openmeddev/Diabeto_Hardware_OpenSource/Diabeto_HW_OpenSource/Documents/Bill Of Material/Diabeto_BLE_BOM.xls

Reference | Value | Quantity | Package | Description | Manufacture | Mfg PN
BAT+,BAT- | 3.7V/55mAh | 1 | 1X01_ROUND | 3.7v/55mAh LIPO rechargable battery, dimension 21.5x10x4mm | Full aim technology Ltd | 8EB-401120
C1,C4,C6,C7,C14, C15,C33 | 0.1uF | 7 | _0603 | CAP CER 0.1UF 10V 10% X7R 0603 | kemet | C0603C104K8RACTU
C2,C3,C12,C13 | 22pF | 4 | _0402 | CAP CER 22PF 50V 5% NP0 0402 | Samsung Electro-Mechanics America, Inc | CL05C220JB5NNNC
C5 | 10uF | 1 | 1206 | CAP CER 10UF 10V 5% X7R 1206 | kemet | C1206C106J8RACTU
C8 | 22uF | 1 | SMD 0805 | CAP CER 22UF 10V 20% X5R 0805 | Samsung Electro-Mechanics America, Inc | CL21A226MPQNNNE
C9 | 47nF | 1 | _0603 | CAP CER 0.047UF 50V 10% X7R 0603 | Samsung Electro-Mechanics America, Inc | CL10B473KB8NNNC
C10 | 2.2uF | 1 | _0603 | CAP CER 2.2UF 6.3V Y5V 0603 | Yageo | CC0603ZRY5V5BB225
C11,C21 | 4.7uF | 2 | _0603 | CAP CER 4.7UF 25V 20% X5R 0603 | Samsung Electro-Mechanics America, Inc | CL10A475MA8NQNC
D1 | BAV70 | 1 | SOT-23 | DIODE ARRAY 75V 150MA SOT23 | Diodes Inc (http://digikey.com/Suppliers/us/Diodes.page?lang=en) | BAV70-7-F
D2 | 1N5817 | 1 | SMA-DIODE/SOD-123 | DIODE SCHOTTKY 40V 1A SOD123 | Diodes Inc | 1N5819HW-7-F
IC1 | ATMEGA8L | 1 | TQFP32-08 | MCU 8bit, 8KB flash,1KB SRAM,512 Bytes EEPROM | Atmel | ATMEGA8L-8AUR
LED1 | WHITE | 1 | CHIPLED_0603 | LED WHITE HIGH BRIGHT ESS SMD, 2.9V, 5mA | Rohm Semiconductor | SMLT12WBC7W1
LED2 | BLUE | 1 | CHIPLED_0603 | LED BLUE HIGH BRIGHT ESS SMD,2.9v, 5mA | Panasonic Electronic Components - Semiconductor Products | LNJ937W8CRA
LED3 | RED | 1 | CHIPLED_0603 | LED RED HIGH BRIGHT ESS SMD, 1.95v, 5mA | Panasonic Electronic Components - Semiconductor Products | LNJ237W82RA
LED4 | GREEN | 1 | CHIPLED_0603 | LED GREEN USS TYPE 0603, 2.03v, 10mA | Panasonic Electronic Components - Semiconductor Products | LNJ314G83RA
NR3015 | 2.2uH, 1.6A | 1 | 1210 | INDUCTOR POWER 2.2UH 1600MA 1210 | Murata Electronics North America (http://digikey.com/Suppliers/us/Murata-Electronics.page?lang=en) | LQH32PN2R2NN0L
R2,R3,R4,R5 | 100E | 4 | _0603 | RES 100 OHM 1/10W 5% 0603 | Stackpole Electronics Inc | RMCF0603JT100R
R1,R6,R7,R15,R17,R22 | 10K | 6 | _0603 | RES 10K OHM 1/10W 5% 0603 | Stackpole Electronics Inc | RMCF0603JG10K0
R8 | 15k | 1 | _0603 | RES 15K OHM 1/10W 5% 0603 | Stackpole Electronics Inc | RMCF0603JG15K0
R9, R20 | 1k | 2 | _0603 | RES 1K OHM 1/10W 5% 0603 | Stackpole Electronics Inc | RMCF0603JT1K00
R14,R12 | 2M | 2 | _0603 | RES 2M OHM 1/10W 5% 0603 | Stackpole Electronics Inc | RMCF0603JG2M00
R16,R19 | 220k | 2 | _0603 | RES 220K OHM 1/10W 5% 0603 | Stackpole Electronics Inc | RMCF0603JT220K
R11,R18 | 1.2M | 2 | _0603 | RES 1.2M OHM 1/10W 5% 0603 | Samsung Electro-Mechanics America, Inc | RC1608J125CS
R23 | 1.5k | 1 | _0603 | RES 1.5K OHM 1/10W 5% 0603 | Stackpole Electronics Inc | RMCF0603JT1K50
R24,R25 | 68E | 2 | _0603 | RES 68 OHM 1/10W 1% 0603 | Stackpole Electronics Inc | RMCF0603FT68R0
R26 | 47K | 1 | _0603 | RES 47K OHM 1/10W 5% 0603 | Stackpole Electronics Inc | RMCF0603JT47K0
S1 | SOFT_BUTTON | 1 | TACTILE_SWITCH_SMD | Tactile Switches 5.2x5.2x1.5mm 260gf | ALPS | SKQGADE010
U$9 | NVC_MDCS71 | 1 | NVC_MDCS71 SMD SOIC | Novacomm Bluetooth4.0 compatible low energy module | Novacomm | NVC_MDCS71
U$17 | ATTINY2313V | 1 | MLF20 | MCU 8bit,2KB flash,128 Bytes SRAM | Atmel | ATTINY2313V-10MU
U1 | MCP73831 | 1 | SOT23-5 | Singel Cell LIPO charger with programmable o/p current upto 500mA | Microchip | MCP73831T-2ACI/OT
U2 | TPS61200 | 1 | QFN-10_PAD | IC REG BOOST SYNC ADJ 1.2A 10SON | Texas | TPS61200DRCR
X1 | USB-MICRO-B | 1 | SMD MID-MOUNT | standard micro usb B type connector | chinaplug | GW-MC510B-01S
Y1 | 8MHz | 1 | CRYSTAL-SMD-5X3 | 5x3.2x1.5mm SMD crystal, +/-50ppm tolerance,300ohm ESR,8pF | NDK | NX5032GA 8MHZ AT-W
Y2 | 12MHz | 1 | CRYSTAL_3.2X2.5 | 3.2x2.5mm SMD crystal | Abracon | ABM8G-12.000MHZ-B4Y-T
 | 2.5mm Audio jack | 1 | PTH | standard 2.5 mm audio connector | chinaplug | 2.5 STEREO PLUG
 | TS3A5223 | 1 | 10-UFQFN | DUAL SPDT ANALOG SWITCH | Texas | TS3A5223RSWR
 | PCB manufacturing | 1
 | Micro-usb cable | 1 |  | USB2.0 to micro usb converter cable | chinaplug
 | Outer casing
R10 | 2K | 1 | _0603 | Resistor 2k | Stackpole Electronics Inc
R21 | 33E | 1 | _0603 | Resistor | Stackpole Electronics
D3 | 1N4001 | 1 | SOD323 | Diode
Q1 | 2N3904 | 1 | SOT23 |  | Fairchild Semiconductor
VIB+, VIB- | 310-101 | 1 | 10mm shaftless vibration motor | 2.5-3.8,70mA,3.4mm button type | Pricision Microdrivers | 310-101
