openmeddev/Diabeto_Hardware_OpenSource/Diabeto_HW_OpenSource/Design Files/Eagle Files/DIABETO_BLE_SCH_SHEET1.pdf

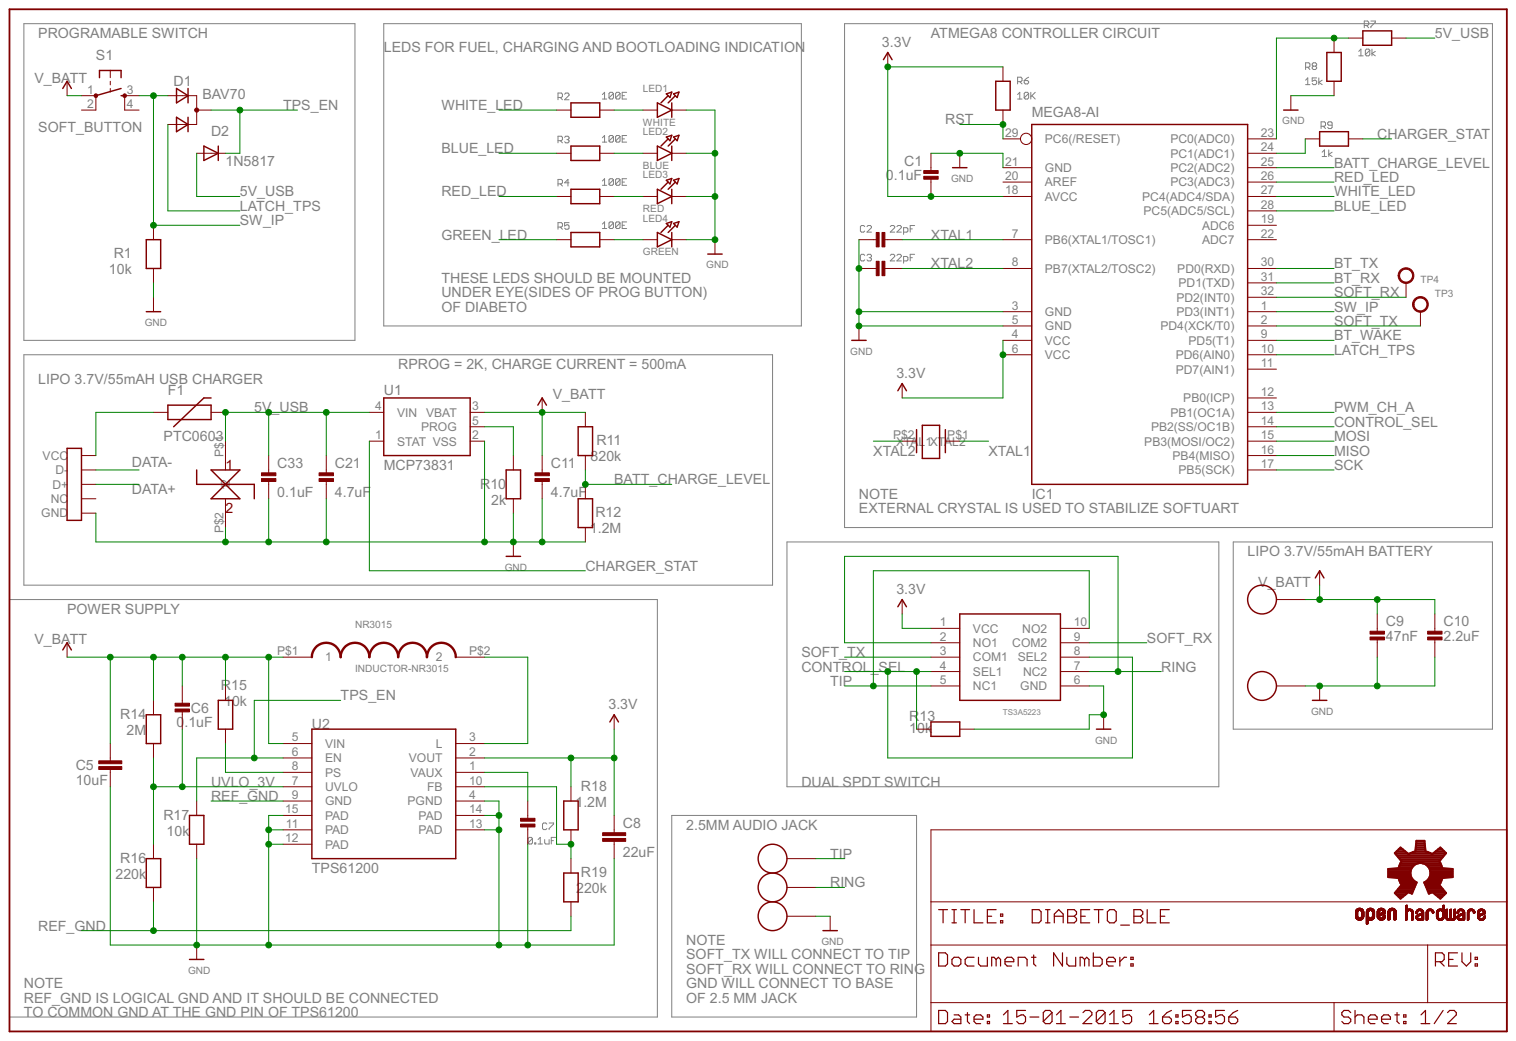
[picture p1: page 1]

LEDS FOR FUEL, CHARGING AND BOOTLOADING INDICATION

THESE LEDS SHOULD BE MOUNTED
UNDER EYE(SIDES OF PROG BUTTON)
OF DIABETO

NOTE
EXTERNAL CRYSTAL IS USED TO STABILIZE SOFTUART

SOFT_TX WILL CONNECT TO TIP
SOFT_RX WILL CONNECT TO RING
GND WILL CONNECT TO BASE
OF 2.5 MM JACK

REF_GND IS LOGICAL GND AND IT SHOULD BE CONNECTED
TO COMMON GND AT THE GND PIN OF TPS61200
