openmeddev/Diabeto_Hardware_OpenSource/Diabeto_HW_OpenSource/Design Files/Eagle Files/DIABETO_BLE_SCH_SHEET2.pdf

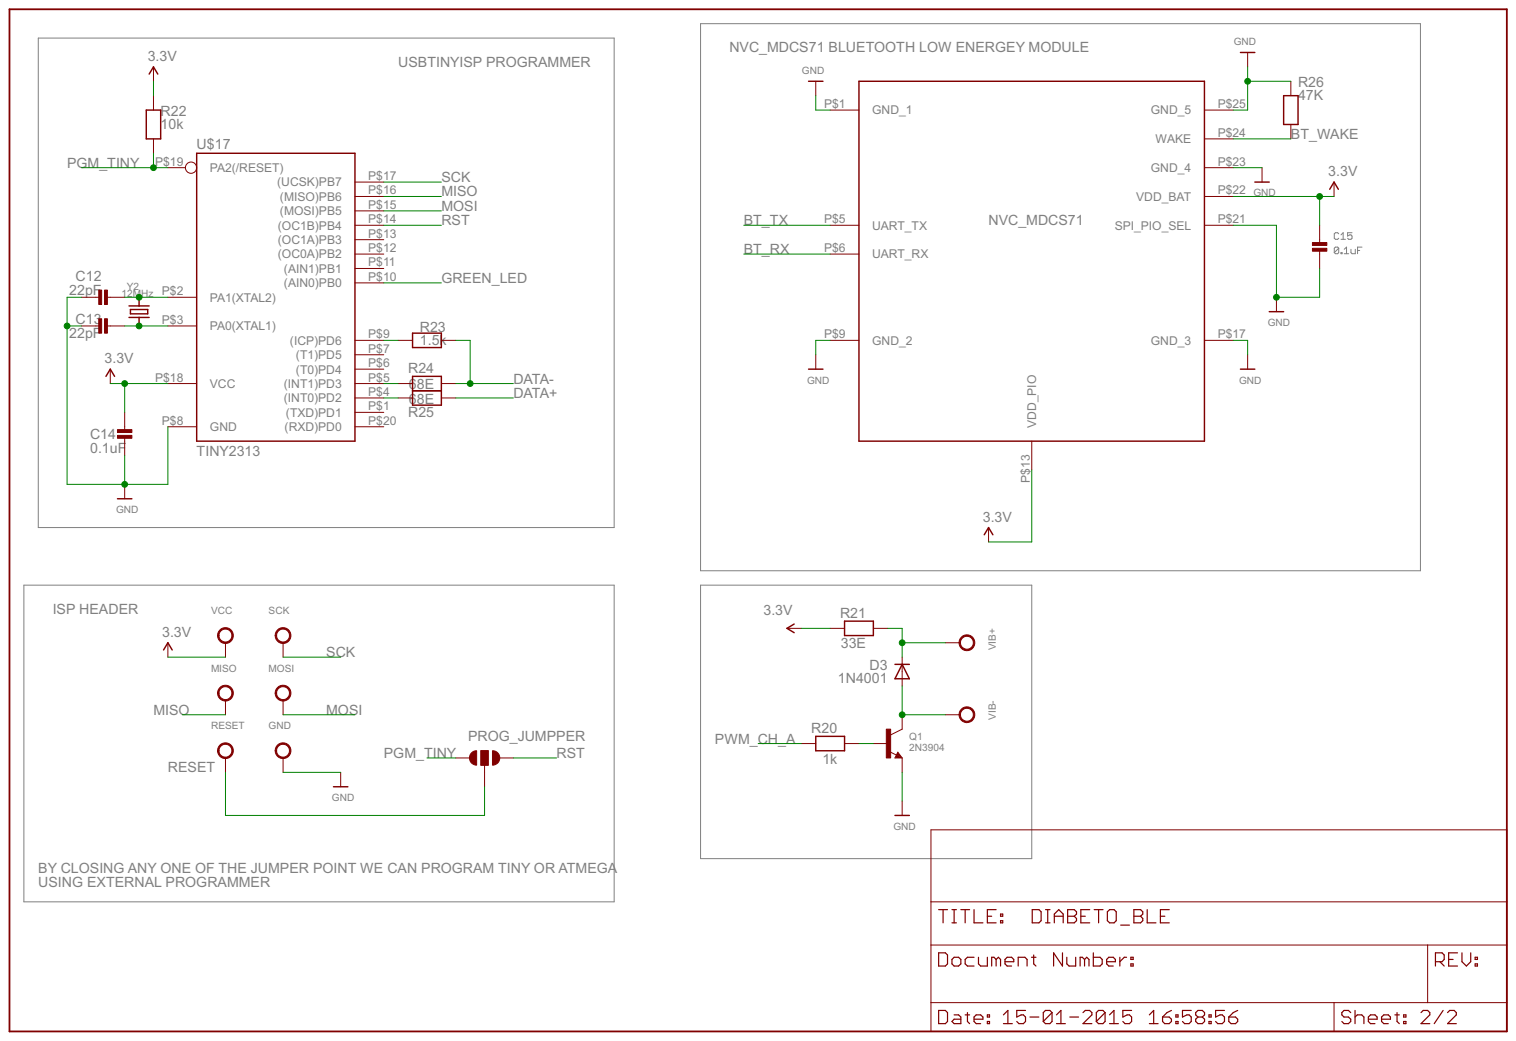
[picture p2: page 1]

NVC_MDCS71 BLUETOOTH LOW ENERGEY MODULE

BY CLOSING ANY ONE OF THE JUMPER POINT WE CAN PROGRAM TINY OR ATMEGA
USING EXTERNAL PROGRAMMER
