openmeddev/Diabeto_Hardware_OpenSource/Diabeto_HW_OpenSource/Documents/Databook/Micro usb 5P_SMT.pdf

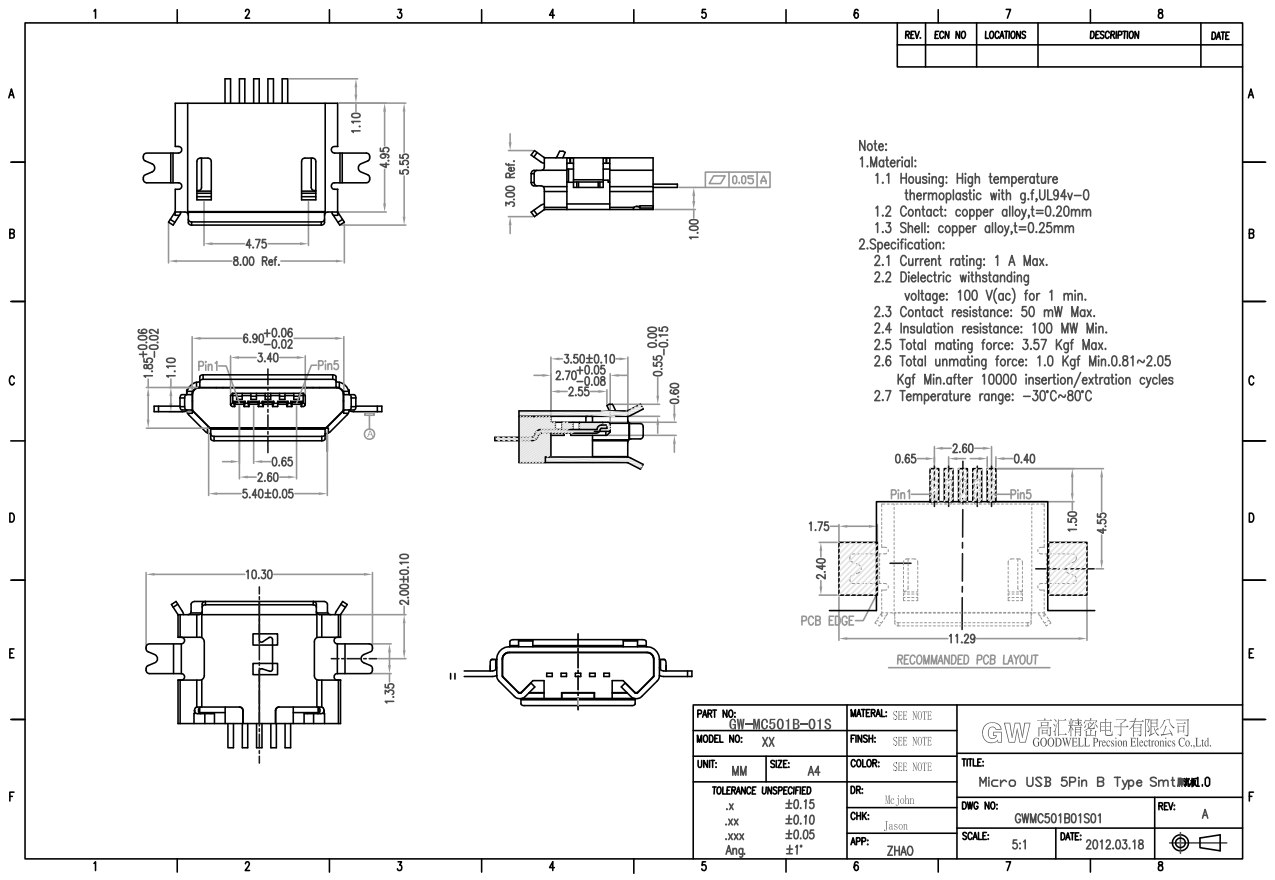
[picture p3: page 1]
