openmeddev/Diabeto_Hardware_OpenSource/Diabeto_HW_OpenSource/Design Files/Eagle Files/DIABETO_BLE.brd

## EAGLE design Diabeto_HW_OpenSource/Design Files/Eagle Files/DIABETO_BLE.brd (2015-01-17)

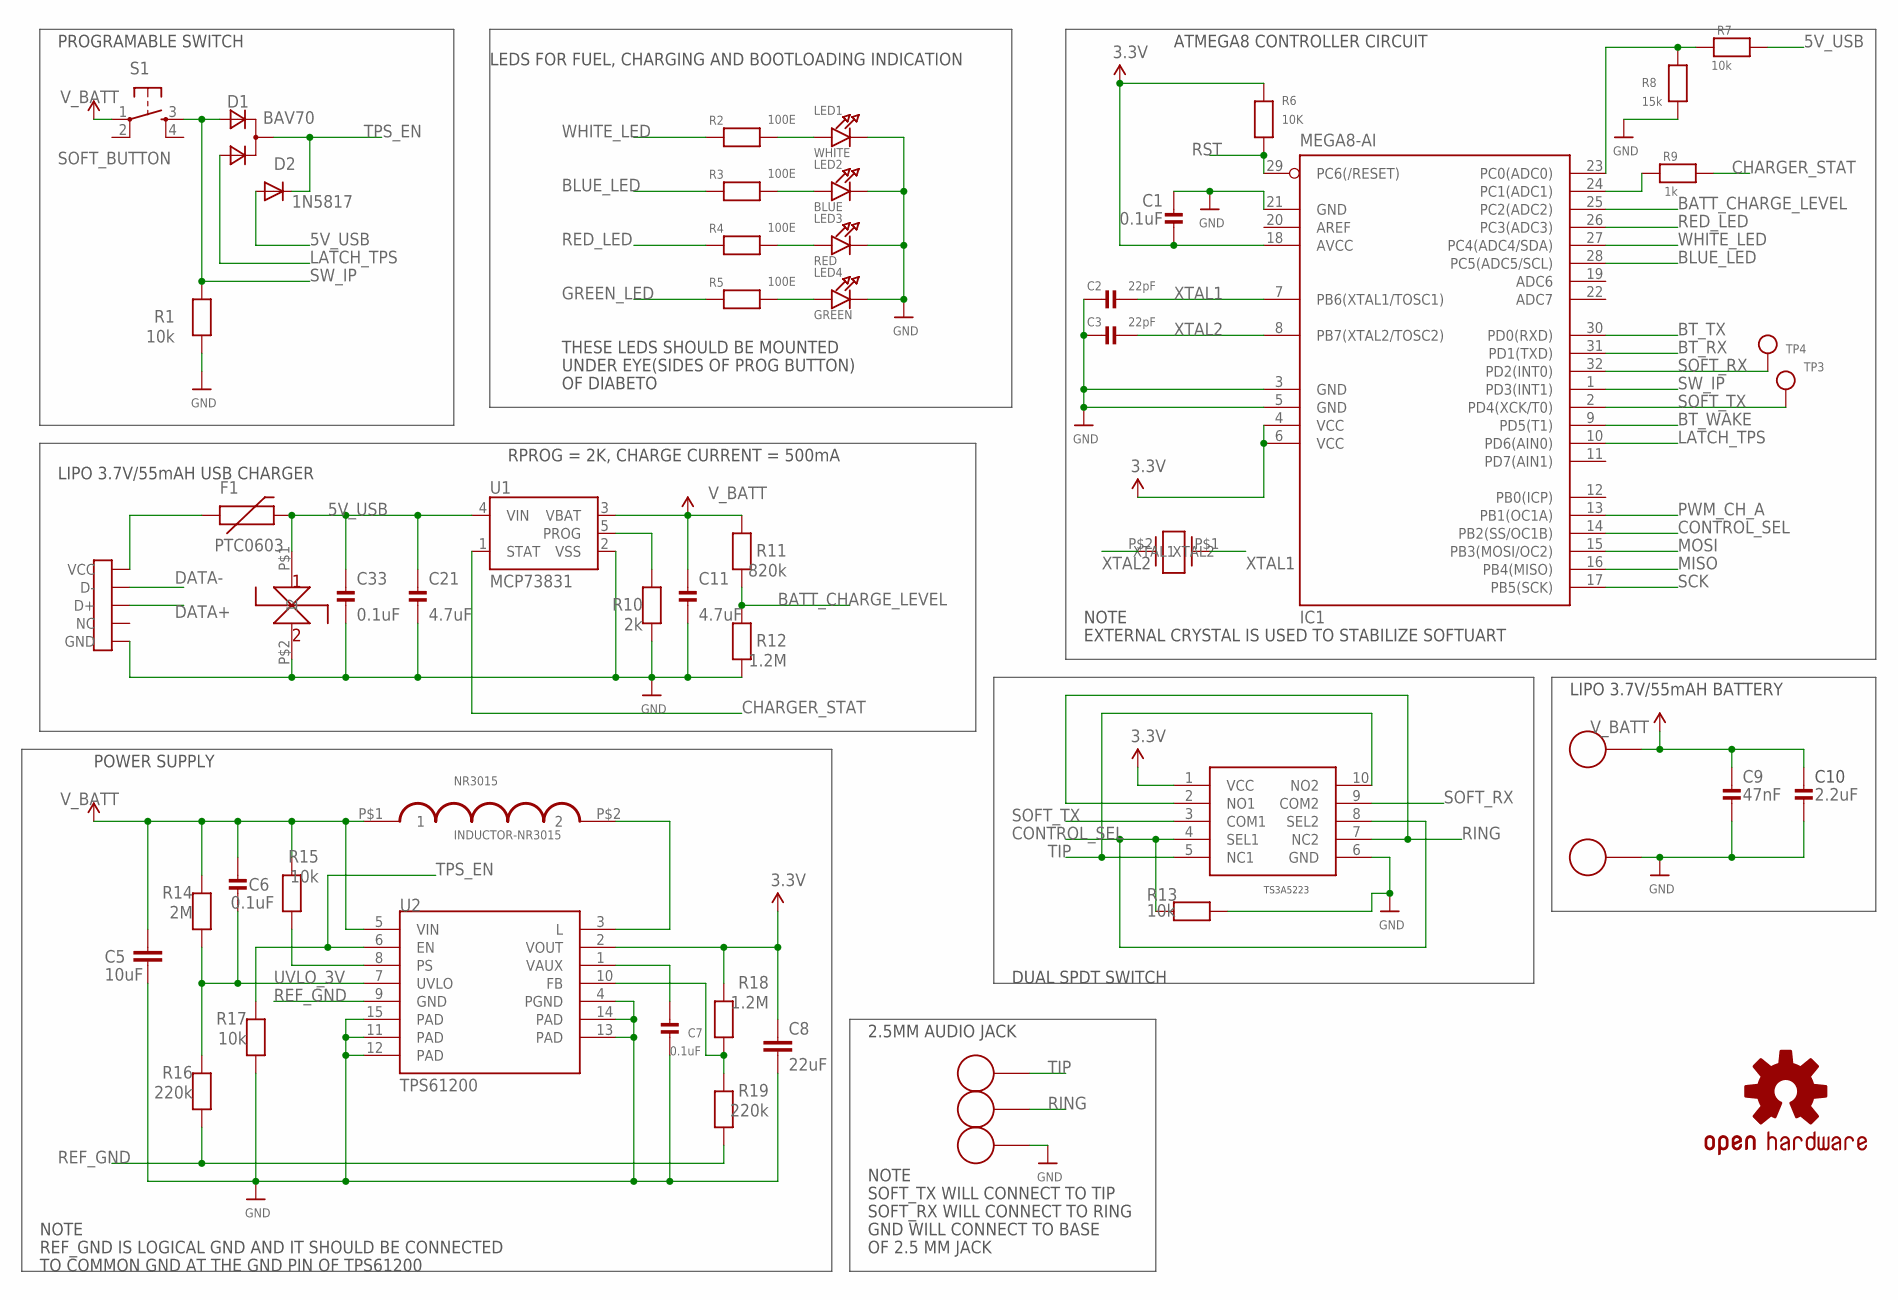
[picture p4: schematic DIABETO_BLE.sch, sheet 1]

Parts:
BAT-: TIP; 1X01_ROUND
C1, C6, C7, C33: 0.1uF; _0603
C2, C3: 22pF; _0402
C5: 10uF; 1206
C8: 22uF; 0805
C9: 47nF; _0603
C10: 2.2uF; _0603
C11, C21: 4.7uF; _0603
D1: BAV70; SOT-23
D2: 1N5817; SOD-123
F1: PTC0603; 0603
IC1: MEGA8-AI; TQFP32-08
LED1: WHITE; CHIPLED_0603
LED2: BLUE; CHIPLED_0603
LED3: RED; CHIPLED_0603
LED4: GREEN; CHIPLED_0603
NR3015: INDUCTOR-NR3015
R1, R7, R13, R15, R17: 10k; _0603
R2, R3, R4, R5: 100E; _0603
R6: 10K; _0603
R8: 15k; _0603
R9: 1k; _0603
R10: 2k; _0603
R11: 820k; _0603
R12, R18: 1.2M; _0603
R14: 2M; _0603
R16, R19: 220k; _0603
S1: SOFT_BUTTON; TACTILE_SWITCH_SMD
TIP, TIP1: TIP; 1X01_ROUND
TP3, TP4: TESTPOINTROUND1MM; TESTPOINT_ROUND_1MM
U1: MCP73831; SOT23-5
U2: TPS61200; QFN-10_PAD
U$2: MICRO_USB_DIABETOMICRO_USB_SMD; MICRO_USB_DIABETO
U$4: TVS_DIODE; 0603
U$20: TS3A5223; TS3A5223-QFN
U$21: OSHW-LOGOS; OSHW-LOGO-S
U$23: 8MHZ; 5X3.2_2PAD
U$26, U$28: 1X01_ROUND

Connections:
3.3V: C1.1, C8.1, IC1.4 (VCC), IC1.6 (VCC), IC1.18 (AVCC), R6.2, R18.2, U2.2 (VOUT), U$20.1 (VCC); also elsewhere on the board
5V_USB: C21.1, C33.1, D2.A, F1.2, R7.1, U1.4 (VIN), U$4.P$1 (1)
BATT_CHARGE_LEVEL: IC1.25 (PC2(ADC2)), R11.1, R12.2
BLUE_LED: IC1.28 (PC5(ADC5/SCL)), R3.2
BT_RX: IC1.31 (PD1(TXD)); also elsewhere on the board
BT_TX: IC1.30 (PD0(RXD)); also elsewhere on the board
BT_WAKE: IC1.9 (PD5(T1)); also elsewhere on the board
CHARGER_STAT: R9.1, U1.1 (STAT)
CONTROL_SEL: IC1.14 (PB2(SS/OC1B)), R13.2, U$20.4 (SEL1), U$20.8 (SEL2)
DATA+: U$2.P$3 (D+); also elsewhere on the board
DATA-: U$2.P$6 (D-); also elsewhere on the board
GND: BAT-.P$1, C1.2, C2.1, C3.1, C5.2, C7.2, C8.2, C9.2, C10.2, C11.2, C21.2, C33.2, IC1.3 (GND), IC1.5 (GND), IC1.21 (GND), LED1.C, LED2.C, LED3.C, LED4.C, R1.1, R8.2, R10.1, R12.1, R13.1, R17.1, U1.2 (VSS), U2.4 (PGND), U2.11 (PAD), U2.12 (PAD), U2.13 (PAD), U2.14 (PAD), U2.15 (PAD), U$2.P$5 (GND), U$4.P$2 (2), U$20.6 (GND), U$28.P$1; also elsewhere on the board
GREEN_LED: R5.2; also elsewhere on the board
L: NR3015.P$2 (2), U2.3 (L)
LATCH_TPS: D1.3 (A2), IC1.10 (PD6(AIN0))
MISO: IC1.16 (PB4(MISO)); also elsewhere on the board
MOSI: IC1.15 (PB3(MOSI/OC2)); also elsewhere on the board
unnamed: R10.2, U1.5 (PROG)
unnamed: LED1.A, R2.1
unnamed: LED2.A, R3.1
unnamed: C7.1, U2.1 (VAUX)
unnamed: R18.1, R19.2, U2.10 (FB)
unnamed: R15.1, U2.8 (PS)
unnamed: F1.1, U$2.P$7 (VCC)
unnamed: LED3.A, R4.1
unnamed: LED4.A, R5.1
unnamed: IC1.24 (PC1(ADC1)), R9.2
unnamed: IC1.23 (PC0(ADC0)), R7.2, R8.1
PWM_CH_A: IC1.13 (PB1(OC1A)); also elsewhere on the board
RED_LED: IC1.26 (PC3(ADC3)), R4.2
REF_GND: R16.1, R19.1, U2.9 (GND)
RING: U$20.2 (NO1), U$20.7 (NC2), U$26.P$1
RST: IC1.29 (PC6(/RESET)), R6.1; also elsewhere on the board
SCK: IC1.17 (PB5(SCK)); also elsewhere on the board
SOFT_RX: IC1.32 (PD2(INT0)), TP4.P$1, U$20.9 (COM2)
SOFT_TX: IC1.2 (PD4(XCK/T0)), TP3.P$1, U$20.3 (COM1)
SW_IP: D1.2 (A1), IC1.1 (PD3(INT1)), R1.2, S1.3
TIP: TIP.P$1, U$20.5 (NC1), U$20.10 (NO2)
TPS_EN: D1.1 (C), D2.C, R17.2, U2.6 (EN)
UVLO_3V: C6.2, R14.1, R16.2, U2.7 (UVLO)
V_BATT: C5.1, C6.1, C9.1, C10.1, C11.1, NR3015.P$1 (1), R11.2, R14.2, R15.2, S1.1, TIP1.P$1, U1.3 (VBAT), U2.5 (VIN)
WHITE_LED: IC1.27 (PC4(ADC4/SDA)), R2.2
XTAL1: C2.2, IC1.7 (PB6(XTAL1/TOSC1)), U$23.P$1 (XTAL1)
XTAL2: C3.2, IC1.8 (PB7(XTAL2/TOSC2)), U$23.P$2 (XTAL2)

Notes on the sheet:
REF_GND IS LOGICAL GND AND IT SHOULD BE CONNECTED
TO COMMON GND AT THE GND PIN OF TPS61200
PROGRAMABLE SWITCH
LIPO 3.7V/55mAH USB CHARGER
ATMEGA8 CONTROLLER CIRCUIT
LIPO 3.7V/55mAH BATTERY
2.5MM AUDIO JACK
LEDS FOR FUEL, CHARGING AND BOOTLOADING INDICATION
THESE LEDS SHOULD BE MOUNTED
UNDER EYE(SIDES OF PROG BUTTON)
OF DIABETO
SOFT_TX WILL CONNECT TO TIP
SOFT_RX WILL CONNECT TO RING
GND WILL CONNECT TO BASE
OF 2.5 MM JACK
EXTERNAL CRYSTAL IS USED TO STABILIZE SOFTUART
NOTE
RPROG = 2K, CHARGE CURRENT = 500mA
POWER SUPPLY
DUAL SPDT SWITCH

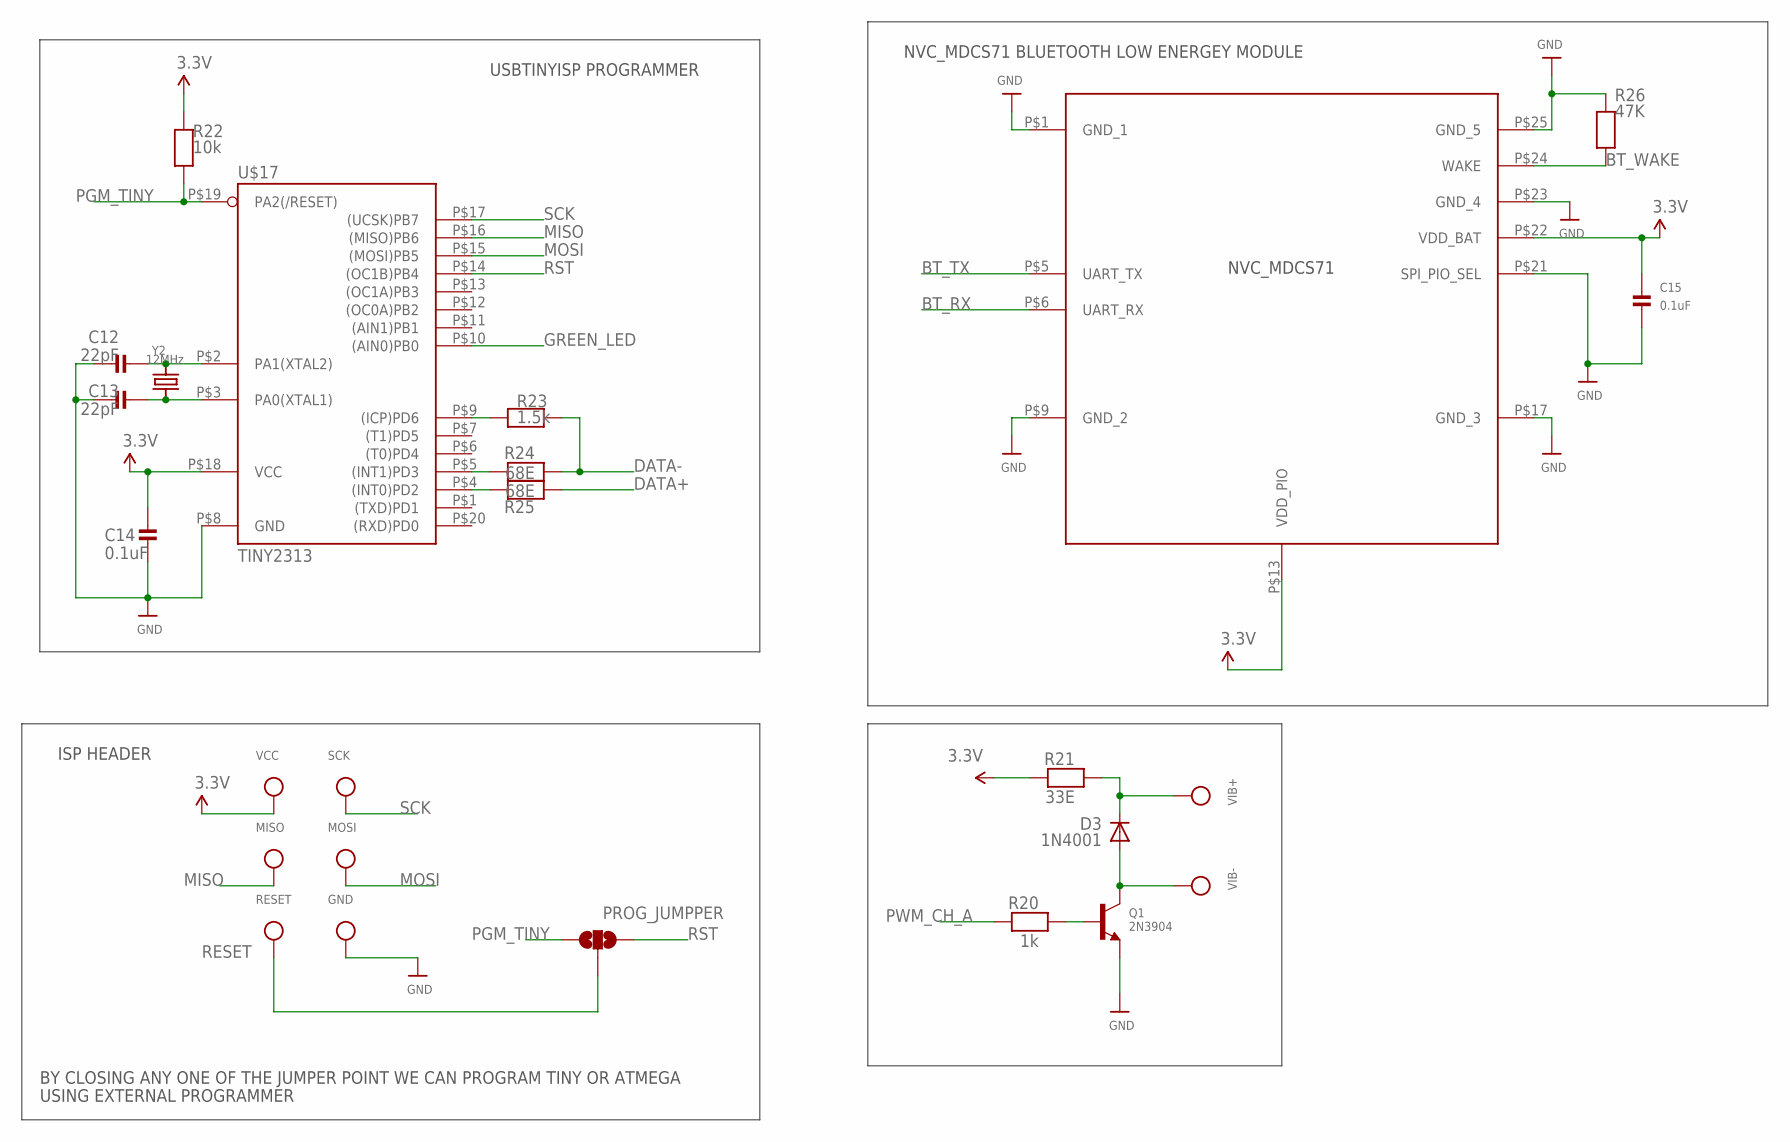
[picture p5: schematic DIABETO_BLE.sch, sheet 2]

Parts:
C12, C13: 22pF; _0402
C14, C15: 0.1uF; _0603
D3: 1N4001; SOD-323
GND: TESTPOINT0.1"; 1X01_ROUND
MISO: TESTPOINTROUND1MM; TESTPOINT_ROUND_1MM
MOSI: TESTPOINTROUND1MM; TESTPOINT_ROUND_1MM
PROG_JUMPPER: SOLDERJUMPER_2WAY-OLDS; SJ_3
Q1: 2N3904; SOT23-R
R20: 1k; _0603
R21: 33E; _0603
R22: 10k; _0603
R23: 1.5k; _0603
R24, R25: 68E; _0603
R26: 47K; _0603
RESET: TESTPOINTROUND1MM; TESTPOINT_ROUND_1MM
SCK: TESTPOINTROUND1MM; TESTPOINT_ROUND_1MM
U$9: NVC_MDCS71SMD; NVC_MDCS71
U$17: TINY2313; MLF20
VCC: TESTPOINT0.1"; 1X01_ROUND
VIB+: TESTPOINTROUND0.5MM; TESTPOINT_ROUND_0.5MM
VIB-: TESTPOINTROUND0.5MM; TESTPOINT_ROUND_0.5MM
Y2: 12MHz; CRYSTAL_3.2X2.5

Connections:
3.3V: C14.1, C15.1, R21.1, R22.1, U$9.P$13 (VDD_PIO), U$9.P$22 (VDD_BAT), U$17.P$18 (VCC), VCC.1; also elsewhere on the board
BT_RX: U$9.P$6 (UART_RX); also elsewhere on the board
BT_TX: U$9.P$5 (UART_TX); also elsewhere on the board
BT_WAKE: R26.2, U$9.P$24 (WAKE); also elsewhere on the board
DATA+: R25.2; also elsewhere on the board
DATA-: R23.1, R24.2; also elsewhere on the board
GND: C12.1, C13.1, C14.2, C15.2, GND.1, Q1.2 (E), R26.1, U$9.P$1 (GND_1), U$9.P$9 (GND_2), U$9.P$17 (GND_3), U$9.P$21 (SPI_PIO_SEL), U$9.P$23 (GND_4), U$9.P$25 (GND_5), U$17.P$8 (GND); also elsewhere on the board
GREEN_LED: U$17.P$10 ((AIN0)PB0); also elsewhere on the board
MISO: MISO.P$1, U$17.P$16 ((MISO)PB6); also elsewhere on the board
MOSI: MOSI.P$1, U$17.P$15 ((MOSI)PB5); also elsewhere on the board
unnamed: D3.2 (A), Q1.3 (C), VIB-.P$1
unnamed: R25.1, U$17.P$4 ((INT0)PD2)
unnamed: D3.1 (C), R21.2, VIB+.P$1
unnamed: C13.2, U$17.P$3 (PA0(XTAL1)), Y2.1
unnamed: C12.2, U$17.P$2 (PA1(XTAL2)), Y2.2
unnamed: R24.1, U$17.P$5 ((INT1)PD3)
unnamed: R23.2, U$17.P$9 ((ICP)PD6)
unnamed: Q1.1 (B), R20.2
PGM_TINY: PROG_JUMPPER.1, R22.2, U$17.P$19 (PA2(/RESET))
PWM_CH_A: R20.1; also elsewhere on the board
RESET: PROG_JUMPPER.2, RESET.P$1
RST: PROG_JUMPPER.3, U$17.P$14 ((OC1B)PB4); also elsewhere on the board
SCK: SCK.P$1, U$17.P$17 ((UCSK)PB7); also elsewhere on the board

Notes on the sheet:
NVC_MDCS71 BLUETOOTH LOW ENERGEY MODULE
USBTINYISP PROGRAMMER
ISP HEADER
BY CLOSING ANY ONE OF THE JUMPER POINT WE CAN PROGRAM TINY OR ATMEGA
USING EXTERNAL PROGRAMMER

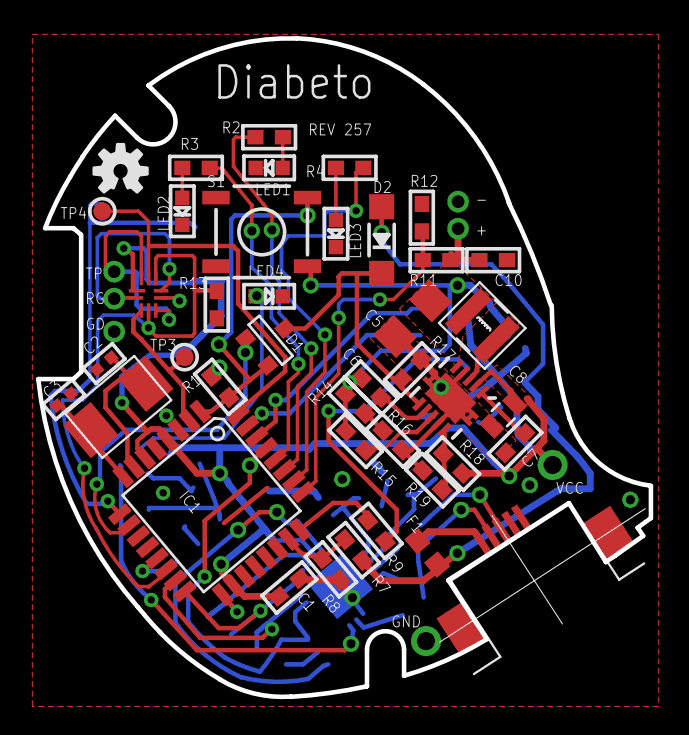
[picture p6: board DIABETO_BLE.brd from above]

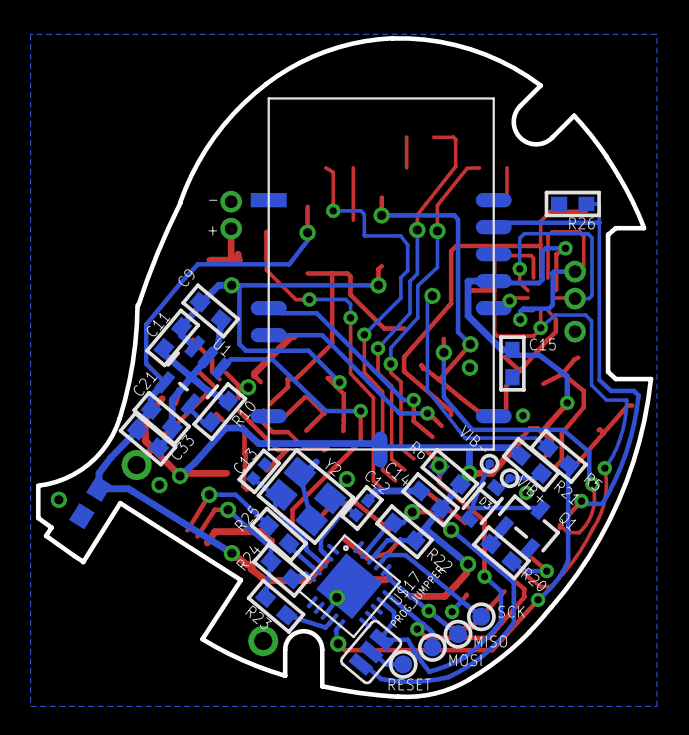
[picture p7: board DIABETO_BLE.brd from below]

Board: 2 copper layers, 34.0 x 36.6 mm, 80 parts (32 on the bottom side), 54 nets.
